serdzz/uflowmeter_msp430fr6043/(commit log)

2026-08-29 Ultrasonic water meter for the MSP430FR6043, built for a battery
    Ping both transducers, work out how much water went past, add it to a reading
    in FRAM, switch the analog section off, sleep. One task, because a meter has
    no interface to be responsive to; at the default interval it is in LPM3 for
    about 99.9% of its life with only the crystal running.
    The brief was minimum energy, so that is the axis every decision is made
    along, and energy.rs computes the budget from the settings at compile time so
    it cannot drift from what the firmware does. Two results in it are not what
    intuition suggests. The correlation costs about two and a half times what the
    ultrasound does -- the front end is on for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
    [config.rs, energy.rs, flow.rs, main.rs, meter.rs, supply.rs, totals.rs]
2026-08-29 Build for the MSP430FR5043 by default
    The FR5043 is the FR6043 without the segment LCD driver, which this meter has
    no use for, in a 64-pin package instead of 80. Everything else about the two
    is identical, down to the base addresses and the memory map, so the firmware
    comes to exactly the same 14140 bytes either way and the chip is now a
    feature.
    The default changed because of supply rather than silicon: the FR6043 is out
    of stock at distributors with a 16-week factory lead time, while the FR5043
    is available and about a third cheaper.
2026-08-29 Structure the firmware for MID conformity assessment
    This is to be sold, which makes it a measuring instrument under MID and its
    software something a notified body assesses against WELMEC Guide 7.2. That is
    cheap to do now and expensive to retrofit, so it is in.
    The change that matters most is that calibration became data. Geometry, the
    zero offset and the correction factor are per instrument, written on a flow
    rig into FRAM and sealed -- they were compile-time constants, which is fine
    for a demonstration and impossible for a product, because a calibration has
    nowhere to go. zero_offset_ps is new and matters more than any of them: the
    two directions are never quite symmetric, and that asymm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
    [calibration.rs, config.rs, flow.rs, main.rs, meter.rs, mod.rs]
2026-08-29 An SSD1306 shown on a button press, and unpowered otherwise
    The display's supply is switched, not its controller. An SSD1306 module's
    sleep command leaves about 26 uA drawn -- more than this whole meter, and
    more than the cell's own self-discharge -- so a display that merely slept
    would be the instrument's largest consumer while showing nothing. Switched,
    at 45 seconds a press and four presses a day, it averages 1.3 uA, which is
    under what the meter draws. Left on it would be 630 uA.
    Two details the hardware and the firmware each have to get right or the
    saving is imaginary. The I2C pull-ups belong on the switched rail: pull-ups
    above an unpowered chip push current through its protection di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
2026-08-29 Switch the display with an IRLML6401, and get the polarity right
    The switch is a P-channel MOSFET, so the pin is low to turn the display on.
    The previous commit had it the other way round -- Level::Low at construction,
    commented as "off" -- which would have powered the display permanently and
    cut it during the one moment it was wanted.
    The inversion now lives in one place, a Power type whose only members are
    on() and off(), because a polarity written the wrong way once tends to be
    read as correct forever after.
    Hardware notes that go with it. The gate needs a 1 MOhm pull-up to the rail:
    between reset and the firmware's first write that pin is an input, and a
    floating gate leaves the switch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
    [display.rs]
2026-08-29 Show a live reading while the display is up, not a snapshot
    The display was drawn once from the reading as it stood when the button went
    down, then held for forty-five seconds. That is the wrong thing: the reason
    somebody stands in front of a water meter with everything closed is to watch
    the last digits and see whether they climb, and a frozen number cannot answer
    that.
    So a showing is now a Session the caller drives. The meter keeps measuring
    while it is up -- once a second rather than its usual interval, since nothing
    is being saved by waiting when the display is already lit -- and redraws
    after each measurement. Only the two text lines are rewritten between frames;
    clearing the panel ea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
    [config.rs, display.rs, energy.rs, main.rs]
2026-08-29 Broadcast the reading over wireless M-Bus
    Mode C1 at 868.95 MHz on a CC1101, transmit only. Never listening is what
    makes a radio affordable here: receiving costs 15.6 mA, so an instrument
    listening even one per cent of the time would draw ten times everything else
    in this meter put together. A frame is about 30 mA for four milliseconds,
    which at one a minute averages 2 uA, and between frames the radio sits in
    SPWD at 200 nA -- below the meter's own sleep current. The cost is that there
    is no downlink at all, which for a meter in a stairwell is the right trade.
    C1 rather than the more usual T1 because T1 encodes every byte as 3-out-of-6
    symbols, and the flash that encoder would take is flas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
2026-08-30 Specify the board for JLCPCB, and correct the transmit current
    hw/ carries the schematic net by net, a bill of materials with LCSC part
    numbers checked against JLCPCB's assembly library, and the layout
    constraints. There is no layout and there are no Gerbers: placing and routing
    a mixed-signal board with an 868 MHz section is work that has to be done on a
    canvas and looked at, and emitting coordinates blind would produce files that
    look orderable and give you a radio transmitting into a mismatched trace.
    Three findings changed the design.
    JLCPCB has no MSP430FR6043 at all, but does have the FR5043 -- the same part
    without the LCD controller, which this design was never going to use because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
    [bom.csv]
2026-08-30 hw: real pin numbers, the ultrasonic front end, and the bug that found
    The pin numbers are read off SLASEF5B section 9.14 and are in hw/PINOUT.md
    for both packages: the 80-pin FR6043 the firmware currently builds for and
    the 64-pin FR5043 the board uses.
    Reading it properly turned up a defect in embassy-msp430, fixed separately:
    P1.7's UCB0SCL is the second alternate, not the third, and selecting the
    third holds SCL low. The display would have been dead on the first board.
    It also corrected something claimed in the previous commit. Table 7-1 lists
    each pin's signals as a block with the port name floating in the middle and
    the pin-number cell centred beside it, so reading it quickly puts ev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
2026-08-30 hw: RF values from TI's reference, the transducer interface, and a netlist
    The 868 MHz section now has real values, taken from TI's CC1101EM 868/915 MHz
    reference design rev 3.0.0 -- the version DN017 calls newest and recommended,
    of three, two of which are marked not to be used. Three parts were missing
    from the first draft and each would have cost a board on its own: R171, the
    56k RBIAS resistor without which nothing transmits; the crystal load
    capacitors, which are 12 pF and 15 pF and not the matched pair anyone would
    reach for; and the ferrite bead in the supply feed. The reference drawing also
    names the inductors -- Murata LQW15A, wirewound -- which DN017's measurements
    say is the diffe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
    [bom.csv]
2026-08-30 hw: a placed board, DRC clean, still unrouted
    uflowmeter.kicad_pcb has all 54 footprints placed on a 70 x 55 mm four-layer
    outline with pours on every layer, built from the netlist by script and then
    checked by rendering it and looking at it. DRC reports zero violations; the
    134 unconnected items are the nets nobody has routed yet.
    The placement went through three rounds. The first had 29 violations --
    0402 parts at 1.5 mm pitch do not clear their own courtyards, and half the
    connectors sat outside the outline. Reading the courtyards back off the board
    found the interesting one: a 2.54 mm header's courtyard runs 11 mm down the
    board, far past its body, which is why the 8 MHz crystal now sit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
    [uflowmeter.kicad_pcb]
2026-08-30 hw: pour the planes and stitch the supplies, 134 unconnected down to 69
    Ground and the supply rails are now carried by the planes rather than left to
    routing, which is what a four-layer board is for. Filling the pours took the
    unconnected count from 134 to 86; sixteen stitching vias taking VCC's surface
    pads down to its plane took it to 70. DRC stays at zero violations.
    The zones connect to pads solidly rather than through thermal spokes. With
    relief, DRC reported starved thermals on the CC1101's ground pads -- a QFN at
    0.5 mm pitch has no room for spokes -- and thermal relief under an RF ground
    is the wrong thing anyway.
    Signal routing is not done, and the attempt is worth recording. Stra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
    [uflowmeter.kicad_pcb]
2026-08-30 hw: J3 is GND VCC SCL SDA, the way the module is actually labelled
    The display header had VCC on pin 1 and ground on pin 2. The module in hand
    is silkscreened GND VCC SCL SDA, so plugging it in would have put the supply
    across it backwards the first time.
    Both orders exist on SSD1306 breakouts, which is why this is now recorded as
    having been read off the part rather than assumed -- it is worth checking
    against the module in hand and not against habit.
    DRC stays clean at 69 unconnected.
    [bom.csv, uflowmeter.kicad_pcb]
2026-08-30 hw: the display mounts on the back of the board
    J3 moves to the reverse side with its pins in a row rather than a column, so
    the module seats directly on it facing outward instead of hanging on four
    flying leads.
    Where it sits was searched rather than chosen. Three constraints, and each
    one rejected the position picked before it. The four drills have to miss
    everything on the front -- the first attempt put them through the 8 MHz
    crystal. The pin row has to run the way the module's does, or the display
    reads sideways. And the 27 mm body has to clear every through-hole pin that
    protrudes on that side, which J1, J4, J5 and BT1 all do; the position before
    this one would have sat the module on t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
    [uflowmeter.kicad_pcb]
2026-08-30 hw: the right half becomes a front panel, display above the button
    The display hangs from J3 at the top of the board, body over x 38.3-65.3,
    y 6-33, with the button directly below it at x 47.2-56.4, y 35.9-46.1 --
    three millimetres between them. Reading on top, button under it, both through
    the same face of an enclosure.
    This could not be done by moving the connector. A 27 mm module above the
    button needs a clear column, and the search for one returned nothing: the
    transducer header and the cell sat in it, and both protrude. So the board was
    rearranged around the panel instead -- transducers to the top left, cell and
    calibration header to the right edge below it, and the display's own passi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
    [uflowmeter.kicad_pcb]
2026-08-30 hw: route twelve signal nets, 70 unconnected down to 36
    Each pad escapes outward to a via and the run happens on the bottom layer.
    That is the only thing that works on a 0.5 mm pitch QFN, where the
    neighbouring pins are half a millimetre away and a straight line from a
    crystal to its pin crosses three of them -- which is why the earlier attempt
    routed one net out of eleven.
    Three bugs stood between that and this, each worth remembering. The escape
    stub was tested against the pad it started from, so no escape ever succeeded.
    The bottom-layer run was tested against surface-mount pads on the top, which
    it passes happily underneath -- fixing that alone took it from two nets to
    eight. And the cl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
    [uflowmeter.kicad_pcb]
2026-08-30 hw: route with a grid router, so the tracks have a shape
    route_maze.py is A* over a 0.1 mm grid on both layers, eight directions, a
    via costed at about five millimetres of track. Octile movement is the point:
    runs come out horizontal, vertical or at 45 degrees rather than as whatever
    straight line happened to be clear, which is what the previous pass produced
    and what looked wrong.
    Three bugs, each of which cost a full run to find.
    A cell claimed by two nets belongs to neither. On a 0.5 mm pitch package the
    neighbouring pins' keep-outs overlap, and letting the first claimant own the
    cell is how a track ends up crossing its neighbour's pad -- 67 violations
    that way, the first time.
    The kee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
    [uflowmeter.kicad_pcb]
2026-08-30 hw: escape a 0.5 mm pitch QFN with 0.15 mm track, not 0.25
    At 0.25 mm nothing could leave U1 or U2 at all, and the grid map shows why.
    The neighbouring pins sit 0.5 mm away and are 0.3 mm wide, so their copper
    edge is 0.35 mm from a pin's own axis. A 0.25 mm track needs 0.275 mm of room
    from its centreline; the two neighbours' keep-outs then meet over the escape
    corridor and close it. There is a solid three-cell band under every pin that
    belongs to two nets at once and so may be used by neither.
    At 0.15 mm the track needs 0.225 mm, the keep-outs stop short of each other,
    and the corridor opens. That is why fine-pitch escapes are routed thin and
    widened once clear of the package, and the wid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
    [uflowmeter.kicad_pcb]
2026-08-30 hw: finer grid, no corner cutting, and a cleanup pass -- 34 unconnected
    Three changes, in the order they mattered.
    The grid went to 0.05 mm. At 0.1 mm the escape corridor beside a QFN pin is
    narrower than one cell and simply vanishes, which is what had been capping
    the result. Making it affordable needed a weighted heuristic and bounding
    each search to the box its net lives in, together worth more than an order of
    magnitude; a run is now two and a half minutes.
    Diagonal steps no longer cut corners. A 45 degree move sweeps the two cells
    beside it, and letting it clip one is how a track ends up a hair too close to
    the pin next door.
    route_cleanup.py drops whatever DRC still objects to. The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
    [uflowmeter.kicad_pcb]
2026-08-31 hw: fabrication export, fiducials, and an honest account of what is left
    make_fab.sh writes the JLCPCB set from the board file: the four copper
    layers, both masks, silkscreens and paste layers, the outline and both drill
    files, zipped, plus the BOM and the placement CSV in the column names the
    assembly step wants. It caught its own bug on the first run -- KiCad names
    Gerbers by layer, .gtl .gbl .g1 .g2 and so on, so a wildcard on .gbr ships an
    archive containing nothing but drill files.
    finish_board.py adds what a router will not: three fiducials in an asymmetric
    L, because a QFN-64 on 0.5 mm pitch is placed from fiducials rather than from
    the board outline, and a legend on both sides.
    The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
    [uflowmeter.kicad_pcb]
2026-08-31 hw: the radio becomes a module, and a real schematic that caught a real bug
    The CC1101 is no longer on this board. Gone with it: its 26 MHz crystal, its
    bias resistor, its supply bead and decoupling, the whole filter balun and the
    notch, and the u.FL connector -- twenty parts. J6 carries eight pins to a
    ready-made module instead, and the firmware did not change by a line.
    That removed the two hardest problems in the design. TI's reference layout no
    longer has to be transplanted, which mattered because it exists only as
    CADSTAR and Gerbers -- readable by a person, not by a script. And EN 300 220
    no longer has to be proven by conducted measurement, which an antenna
    connector on your own board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
    [bom.csv, uflowmeter.kicad_pcb, uflowmeter.kicad_sch]
2026-08-31 hw: the board is routed -- zero violations, zero unconnected
    32 footprints, 222 tracks, 89 vias on 70.1 x 55.1 mm of four-layer board.
    DRC clean, ERC clean, and fab/ holds the Gerbers, both drill files, the BOM
    and the placement list.
    The last connections came in once one rule was written down. A 0.6 mm via
    needs 0.525 mm of clear board to a foreign track -- its own radius, plus the
    clearance, plus the other track's half width -- and escapes from adjacent
    pins of a 0.5 mm pitch package run 0.5 mm apart. That is always a hair too
    close, so a via never goes directly behind a pin: one of each adjacent pair
    fans sideways first. That was needed four times, for I2C_SCL/BUTTON,
    DISP_GATE/RADIO_CS,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
    [uflowmeter.kicad_pcb, uflowmeter.kicad_sch]
2026-08-31 hw: fix the two things the assembly house rejected
    Fiducials were in the placement file. They are copper marks, not parts, so a
    house asked to place FID1 stops and writes to you. They are filtered out now.
    BT1 had no BOM line at all -- it was dropped when the BOM was rewritten for
    the radio module, and nothing caught it until the order was uploaded. A
    designator in the placement file with no BOM line is exactly the error that
    came back.
    make_fab.sh now cross-checks the two files and refuses to write anything if
    they name different parts, so this cannot be found by the vendor again.
    While in there, the passives got their LCSC numbers, which they had never
    had: 22 parts on 13 lines are now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
    [bom.csv, uflowmeter-bom.csv]
2026-08-31 hw: a switch the assembly house actually stocks
    SW1 was a CK KSC7xx, which has no stocked equivalent, so the button came back
    as an unmatched component and would never have been placed. It is now an ALPS
    SKQGADE010 -- C116647, 88,965 in stock -- for which KiCad already carries a
    checked footprint, so nothing had to be drawn from a description.
    The swap moved its pad by 0.2 mm and taught two things.
    Its footprint carries a keepout on the top layer, and rightly: there is a
    metal dome under the button and copper there would short against it. BAT+ ran
    straight through it. The keepout binds only the top layer, so BAT+ now passes
    underneath on the bottom and comes up west of the switch.
    And RST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
    [bom.csv, uflowmeter.kicad_pcb, uflowmeter.kicad_sch]
2026-08-31 hw: how to bring the first board up
    Rev A is ordered, so the useful thing now is the order to check it in. Each
    step is what makes the next one interpretable; skipping one turns a clear
    failure into a puzzle.
    Three of the steps are worth naming here because they are where this design
    is most likely to be wrong.
    I2C is the step most likely to fail, and for a known reason: P1.7's UCB0SCL
    is the second alternate function and embassy-msp430 had it as the third until
    the datasheet was actually opened. If SCL never toggles, that is where to
    look.
    The IRLML6401's leakage at 3 V is the measurement that decides battery life
    and the one number its datasheet does not give -- it quotes -1.0 uA at -12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
2026-08-31 hw: the MSP-FET430UIF works, and is the better probe for this board
    TI's MSP Debuggers guide marks it as supporting all programmable MSP430 and
    CC430 devices over both JTAG and Spy-Bi-Wire, so the FR5043 is covered. It is
    the MSP-FET430PIF -- the parallel-port one -- that the same table footnotes as
    legacy, supporting nothing released after 2011.
    Its linear regulator is a reason to prefer it here rather than a sign of its
    age. The guide recommends an emulator with an integrated linear regulator for
    sensitive analog and RF circuits, because the current MSP-FET and eZ-FET use
    a DC-DC converter that puts 5-50 mV of ripple on the target supply. This
    board measures picoseconds and carries a radi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
2026-08-31 hw: the calibration interface, and which USB-serial adapter is safe
    J5 runs at 115200 8N1 -- Config::default() in the HAL, which the firmware
    does not override -- and that was written down nowhere.
    The adapter has to be 3.3 V. The board runs from a 3.6 V cell and an MSP430
    pin tolerates VCC + 0.3 V, while most FT232R breakouts carry a 5 V / 3.3 V
    jumper and ship on 5 V. In that position it drives 5 V into P4.4, past the
    absolute maximum. An FT230X or FT231X takes its level from VCCIO and has no
    such trap. FTDI's FT200XD and FT201X are USB-to-I2C, not UART, and will not
    talk to J5 at all.
    Also recorded: do not send S until a flow rig says so. It is irreversible --
    the firmware never opens t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
2026-08-31 hw: how to use uss_scope, and how to pick the burst threshold
    uss_scope speaks over the same J5 header at the same 115200 and prints the
    samples the receiving transducer actually produced, which is the only honest
    way to choose a threshold, a gain and a capture window. It is the first thing
    to run on a new board and it comes before believing any number a meter
    produces -- flow reports a difference in flight time you have no way to check.
    It ends each pair of captures with a suggestion, and the reasoning behind it
    is worth knowing rather than just taking: half the *smaller* of the two
    peaks. Comfortably above noise, below both, and the smaller one matters
    because a threshold that catches one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
2026-08-31 hw: the cell is not the limit, and the leakage claim was overstated
    Working the numbers rather than repeating them: an ER34615 is 19 Ah and a
    bobbin Li-SOCl2 cell self-discharges at about 1 % a year -- 190 mAh, or
    21.7 uA written as a current. That is more than this whole instrument draws,
    four times over when no radio is fitted. So the design is limited by the
    cell's shelf life and its passivation, not by capacity, and every case comes
    out at sixty to eighty-six years against a ten to fifteen year design life.
    Which makes a claim this repository has been repeating wrong. The IRLML6401's
    leakage was described as something that could quietly halve the battery life.
    Against 21.7 uA of self-di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
    [display.rs]
2026-08-31 hw: clamp-on transducers -- fine for the bench, not for the instrument
    Clamping a pair to any pipe is the quickest way to a first waveform and the
    right way to bring the front end up: no spool piece, and you can move them
    while watching the plot. What has to change is recorded -- more gain, a lower
    threshold, a longer window, more excitation pulses -- along with the wedges
    and couplant, without which the beam never enters the water usefully.
    The reason it cannot carry a billing instrument is not signal quality. This
    firmware is built for MID, where the instrument is sealed and its
    metrological characteristics are verifiable, and a clamp-on measurement
    depends on the pipe wall, the couplant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
2026-08-31 hw: which transducers to buy, and whether clamp-on can work at 3.6 V
    TI's whole FR6043 ecosystem is aimed at wetted transducers -- the EVM ships
    without any, and the water reference designs are inline. Clamp-on is not a
    case TI addresses, and the reason to expect trouble is the drive: this
    excitation stage runs from the same 3.6 V rail as everything else, while
    commercial clamp-on meters hit the transducer with tens of volts precisely to
    cover the 20-40 dB lost in two pipe walls. That headroom is not available
    here, so a clamp-on attempt may fail for want of energy rather than for want
    of a setting. uss_scope answers it cheaply.
    If tried anyway: a TUF-2000-style TS-2 pair at 1 MHz for DN15-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
2026-08-31 hw: real transducers, and what their impedance says about PVCC
    TI lists Audiowell's AUWE-3P-FLOWSENSORPIPE as working with the
    EVM430-FR6043: a complete spool piece with the transducers already fitted,
    DN15/20/25. HS0016 is polymer on an NSF-approved material, 1090 kHz, 25-75
    ohm, 1130 pF; HS0002 is brass, 975 kHz, <=110 ohm, 1350 pF. Both around 1
    MHz, both U-type reflecting paths.
    They settle the question this file has been carrying: Audiowell's bare US0078
    quotes an allowable max input of 5 Vp-p, so these are made to be excited at
    logic level rather than by a 50 V pulser. A 3.6 V rail is inside what they
    expect, and a receiving signal of 350 mV is generous against the ADC.
    Which then ex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
    [bom.csv]
2026-09-01 hw: do not ship a paste layer with nothing on it
    Every part on this board is on the top side -- 32 footprints, none flipped --
    so the bottom paste gerber came out as a bare header, 491 bytes and not one
    aperture. A fab house asked to make a stencil of nothing quite reasonably
    asks what you meant, and that is the warning.
    make_fab.sh now checks each paste layer for aperture commands and drops any
    that has none, rather than hard-coding which side this particular board uses.
    The bottom silkscreen stays: it carries the legend deliberately.
2026-09-01 hw: two nets were routed twice, and nothing was watching for it
    CH1 carried 59 mm of copper and four vias where one path does; USSXTIN and
    LFXIN each had a complete second route laid beside the first. Both routing
    passes took every net rather than only the unfinished ones, so the second
    pass rebuilt work the first had already done.
    DRC cannot see this. Both paths are on the same net, so nothing shorts and
    nothing is unconnected -- the board reported zero violations and zero
    unconnected while carrying copper nobody asked for. Watching those two
    numbers, which is all this project had been doing, is blind to it.
    The first attempt at a guard was worse than none. GetRatsnestForNet hands
    back an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
    [uflowmeter.kicad_pcb, uflowmeter.kicad_sch]
2026-09-01 hw: every track on the 0/45/90 grid
    The angle histogram is now 0, 45, 90 and 135 and nothing else. Three fixes,
    none of them in the routing proper.
    The fan escapes had arbitrary slopes. A fan separates two adjacent pins'
    escapes, and its sideways step and downward step have to be equal for the
    diagonal to come out at 45 degrees; setting them independently gave 11, 10,
    15 and 1.8 degrees.
    The supply stitcher stepped its candidate vias round the pad in 30 degrees,
    so the stub between pad and via landed at 60. Multiples of 45 only now. That
    edit had been attempted once before by pattern replacement and silently did
    not apply -- the numbers gave it away, 0.375 and 0.65 over a length of 0.75
    be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
    [uflowmeter.kicad_pcb, uflowmeter.kicad_sch]
